kcuzner/led-watch/cad/Custom.fcstd

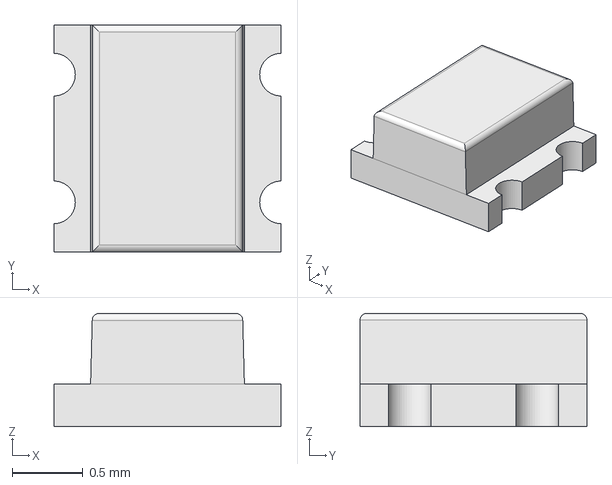
[picture p3: CAD file, 2016-12-05]
cad/Custom.fcstd
1.60 x 1.60 x 0.8 mm
