kcuzner/led-watch/(list of files, cad)

Other CAD files:
cad/stencil.blend
