kcuzner/led-watch/(threads)

Thread 2 (2022-01-03):

I need your help

yap241986, 2022-01-03:
Can you create a boot loader for Debian?
Or how can I?

kcuzner, 2022-01-03:
I'm not sure what you are asking? The project you have commented on is a bare-metal microcontroller-based project and the bootloader here is a structure which facilitates choosing which of two binaries to run. It is not able to, and cannot ever, boot Linux.

Bootloaders for operating systems like Linux are somewhat more complicated, but you can use projects like [Yocto](https://www.yoctoproject.org/) to get started. If you're trying to make a UEFI-compatible bootloader, I would suggest reading the [grub2](https://github.com/rhboot/grub2) source code (or perhaps just using grub directly).

I'm feeling generous, so I'll write you a book as an answer :).

You're going to have to get a lot more specific and do a lot more research, but here are some questions to help you get started:

 - What hardware are you developing for?
   - **Traditional motherboard, using a processor from AMD/Intel/etc**: Check out grub and UEFI, learn how they work. If you're interested in writing a BIOS, most companies hire out a vendor like [Phoenix Technologies](https://www.phoenix.com/) to write their BIOS's. Writing a BIOS is extraordinarily complex and not something you'll be able to do on your own until you learn a lot more, start a company, and sign a few NDAs with AMD and Intel.
   - **A microcontroller, like this project**: A "bootloader" for these systems is a small piece of software that runs before the actual application is run in order to decide which version to run. This is inherently linked to the concept of "firmware update" and providing a "fallback" for the case where a firmware update is interrupted by the power being shut off or a communications error.
     - Most microcontrollers cannot run Linux in the first place. They don't have an MMU or the required protections for an operating system like Linux to run correctly. You need an applications processor, such as an ARM Cortex-R82 or something more advanced. Many vendors, including Microchip Inc, ST, NXP/Freescale, and TI create Linux-capable microprocessors and will provide bootloaders for you.
 - Why do you need to write a bootloader?
   - If you need to write it so you can faciliate firmware update to a single-program microcontroller, than this repo should be able to help you get started.
   - If you don't know why you need a bootloader, then you probably don't need one.
     - Most PCs, including embedded ones like the Raspberry Pi, have a bootloader already built-in for you. Custom bootloaders are a big deal and very complex. One of those things where "if you're asking the question, you don't know what you don't know".
     - Most microprocessors have a bootloader supplied by their vendor, if they even require a bootloader (many of them don't, especially if they've got integrated flash memory). Unless you have a company and are signing NDAs, you cannot write your own bootloader for these and you must use theirs.
     - Most microcontrollers do not require a bootloader to function at all and many applications can get away with not having any sort of bootloader. You'll only need one if you're intending to support in-field firmware updates really.

Closed 2022-01-04.

Thread 4 (2023-07-31):

ARM assembly error in file /common/src/debug.c line 55

Eqqm4n, 2023-07-31:
Hello- been porting this code and compiling under Segger Embedded Studio for ARM 7.12 (I care about the bootloading, not the watch functionality, as a point of reference).  This generates a compile error in debug.c line 55, the line itself is 'movs r1, lr'.  The error given is:

invalid instruction, any one of the following would fix this:
instantiated into assembly here
operand must be an immediate in the range [0,255]
instantiated into assembly here
operand must be a register in range [r0, r7]
instantiated into assembly here

Since I noticed that the original source looked to be compiled as a project for Atollic Studio which is now part of ST's CubeMX IDE, I compiled this under Cube as well and happened to get this same error.  This code is included as part of the replacement Hard Fault handler, so I looked at the default handler provided by Segger and saw it was virtually identical.  So replacing the 'movs' with 'mov' as Segger uses addressed the problem.  Note that this doesn't ensure the code is functionally correct, it just removes a compilation error.  The complete section is as follows:
movs r0, #4
movs r1, lr,
test r0, r1
I believe the 's' suffix tells the ALU status bits to update after the operation.  So if the test command is checking these ALU bits based on the move from the link register, then this will be incorrect, but I don't know how to rewrite this to remove the compilation error and still get the same result of updating the status bits.  It could also be that the test command does not rely on the status bits from the previous two instructions, in which case they can both be replaced with 'mov' (Segger has 'movs' then 'mov') but I haven't done a thorough investigation of what is happening to the processor in this sequence.

kcuzner, 2023-08-06:
I've seen this happen when the wrong core is selected. This specifically was written to compile for the STML052, which I believe is a Cortex-M0+ (and the + is a big deal). The other thing is that this was originally written for GCC, via `arm-none-eabi-gcc`. The original source of cmsis was indeed found in STM32Cube, but the rest of it was written by myself and did not use any IDE (just Makefiles and GCC). That said, looking at debug.c it doesn't fit with my own style and so I wouldn't be surprised if I lifted that from somewhere else. But nonetheless, it was known to compile for GCC.

It's been a long time, but I believe what that code is doing is checking if it should be using the PSP or MSP as the stack pointer and loading whatever is pointed to by stack pointer into the 5th position of the argument array for `HardFault_HandlerC` (`stacked_lr`?). I think when a hard fault happens the `lr` gets updated with a flag saying if the MSP or PSP was in use and so this is decoding that value and allowing the `stacked_lr` value to point to the correct new link register. But I'm guessing. It's been a long time like I said :).

Looking at your code, I don't think there's any reason we need to have `mov` update the status flags. All it's trying to do is `LR & 0x4` and the `tst` operation is setting the flags that the subsequent `beq` uses. So I think that change is safe.

kcuzner, 2023-08-06:
I would suggest if you're hoping to use my bootloader that you consult my https://github.com/kcuzner/midi-fader project for the latest iteration. This one hasn't been tested in a while and I do recall some unreliability issues I had. The midi-fader one is better.

Eqqm4n, 2023-08-08:
Thank you for the response.  All of the STM32L0 line should be Cortex M0+so I wouldn't expect a compilation difference on those lines between the L052 and L062.  The code seems questionable on its face since with two 'movss' commands in a row the flags from the first move are being replaced without even being tested.  I'm sure it probably hasn't been properly reviewed in decades :).

I'll give the midi-fader project a check.  If you actively maintain projects it may be worth it to split bootloading off into its own separate repository.  I only ended up here after finding a reference to your project on an Adafruit blog when looking up STM32 bootloaders on the web.

kcuzner, 2023-10-08:
I'll take that suggestion for having a separate repository for the bootloader, though my personal projects (which all of these are) tend to focus more on learning something new and thus I tend to go with the "copy paste" style of leverage, iterating on the thing after pasting and rarely revisiting or backporting.

Closed 2023-10-08.

Thread 5 (2023-08-06):

Bootloading Python script cannot find attached watch

Eqqm4n, 2023-08-06:
The wristwatch.py script function 'find_device' starting at line 64 cannot connect to an attached watch.  It is looping over all the detected HID devices that match the VID/PID for the watch and then checking for the correct Manufacturer/Product pair.  However, this information is not present in the HID objects being generated by the hid.enumerate() function.  If you print one of these objects you get this ::

{'path': b'3-2:1.0', 'vendor_id': 5824, 'product_id': 1500, 'serial_number': '', 'release_number': 17, 'manufacturer_string': '', 'product_string': '', 'usage_page': 0, 'usage': 0, 'interface_number': 0}

...so you can see that the Manufacturer/Product entries are null values.  This makes sense since the MANUFACTURER='kevincuzner.com', PRODUCT='LED Wristwatch' values that are being searched for don't appear in the STM32 project code.  The USB descriptor defined for the watch in the usb_desc.c file is ::
/**
 * Device descriptor
 */
static const USB_DATA_ALIGN uint8_t dev_descriptor[] = {
    18, //bLength
    1, //bDescriptorType
    0x00, 0x02, //bcdUSB
    0x00, //bDeviceClass (defined by interfaces)
    0x00, //bDeviceSubClass
    0x00, //bDeviceProtocl
    USB_CONTROL_ENDPOINT_SIZE, //bMaxPacketSize0
    0xc0, 0x16, //idVendor
    0xdc, 0x05, //idProduct
    0x11, 0x00, //bcdDevice
    1, //iManufacturer
    2, //iProduct
    0, //iSerialNumber,
    1, //bNumConfigurations
};
...so as can be seen here, iManufacturer and iProduct don't point to a string.  To get around this issue I am simply disabling the checks for Manufacturer/Product and just returning the first object found matching the correct VID/PID which should already be unique enough as it is.  But I'm left curious though as to how this code could have ever worked initially.

kcuzner, 2023-08-06:
This is a permissions issue. You need to see if the handle to the device in `/dev` is readable and writable by your user. If it isn't you'll not be able to actually query the device. Similar behavior can be observed by running `lsusb -v` and then `sudo lsusb -v`. You'll find that the `sudo` version outputs much more information as it opens the device handles and queries for more extensive information.

To remedy this you'll need to either run the python script with `sudo` or add a `udev` rule like this to `/etc/udev/rules.d/`. I typically name mine something like `99-hidraw.rules` or `10-voti.rules`. The number at the beginning is used for sorting to ensure a certain order when processing the rules.

```
# Permissions for libusb raw acccess
SUBSYSTEM=="usb", ATTRS{idVendor}=="16c0", ATTRS{idProduct}=="05dc", MODE="0666"

# Permissions for higher-level hidraw access (this is what Python uses)
KERNEL=="hidraw*", ATTRS{busnum}=="1", ATTRS{idVendor}=="16c0", ATTRS{idProduct}=="05dc", MODE="0666"
```

Eqqm4n, 2023-08-08:
Thank you for the response.  I'm not clear on how this comes down to a permissions issue since as I mentioned the 'kevincuzner.com' and 'LED Wristwatch' strings don't appear anywhere in the C code, so how could they possibly be included in the USB descriptor?

kcuzner, 2023-10-08:
Sorry for the late reply. Please see this file: https://github.com/kcuzner/led-watch/blob/master/firmware/src/usb_desc.c

In my later projects, such as the midi-fader, I used an xml-based `descriptorgen.py` which scans comments for XML and assembles the descriptors from them, including string descriptors like these.

Thread 6 (2023-08-06):

Error attempting to open HID object

Eqqm4n, 2023-08-06:
The hidapi library crashes attempting to open the object returned by the wristwatch.py script's find_device() function ::

Traceback (most recent call last):
  File "/home/perfecta/Downloads/led-watch-master/host/bootloader", line 68, in <module>
    main()
  File "/home/perfecta/Downloads/led-watch-master/host/bootloader", line 54, in main
    with open_bootloader(args.timeout) as dev:
  File "/home/perfecta/Downloads/led-watch-master/host/device/wristwatch.py", line 40, in __enter__
    self.open_path(self.path)
  File "hid.pyx", line 157, in hid.device.open_path
OSError: open failed

If you check the file name and line number reported for hid.pyx you'll see this function ::

    def open_path(self, bytes path):
        """Open connection by path.

        :param path: Path to device
        :type path: bytes
        :raises IOError:
        """
        cdef char* cbuff = path
        if self._c_hid != NULL:
            raise RuntimeError('already open')
        self._c_hid = hid_open_path(cbuff)
        if self._c_hid == NULL:
            raise IOError('open failed')
        self._close = weakref.finalize(self, _closer.wrap(self._c_hid).close)
...and I verified that the 'path' parameter is this object :: {'path': b'3-2:1.0'}.  In order to raise the IOError then there must have been a failure of the hid_open_path() function call, but how to troubleshoot this further is unclear as I don't know how to reconstruct the 'cdef char* cbuff = path' line when trying to do these things step by step via running the Python interpreter directly.

kcuzner, 2023-08-06:
Please check that your user is able to access the hidraw handle and/or USB handle in `dev` and if it doesn't have write permissions, add a `udev` rule or use `sudo` to run the script as noted in #5

Eqqm4n, 2023-08-08:
Thank you for the response.  Running the script with sudo cleared that up.

Closed 2023-10-08.
