kcuzner/led-watch/kicad/simple-led-watch.kicad_pcb

## KiCad design kicad/simple-led-watch.kicad_pcb (2017-01-29)

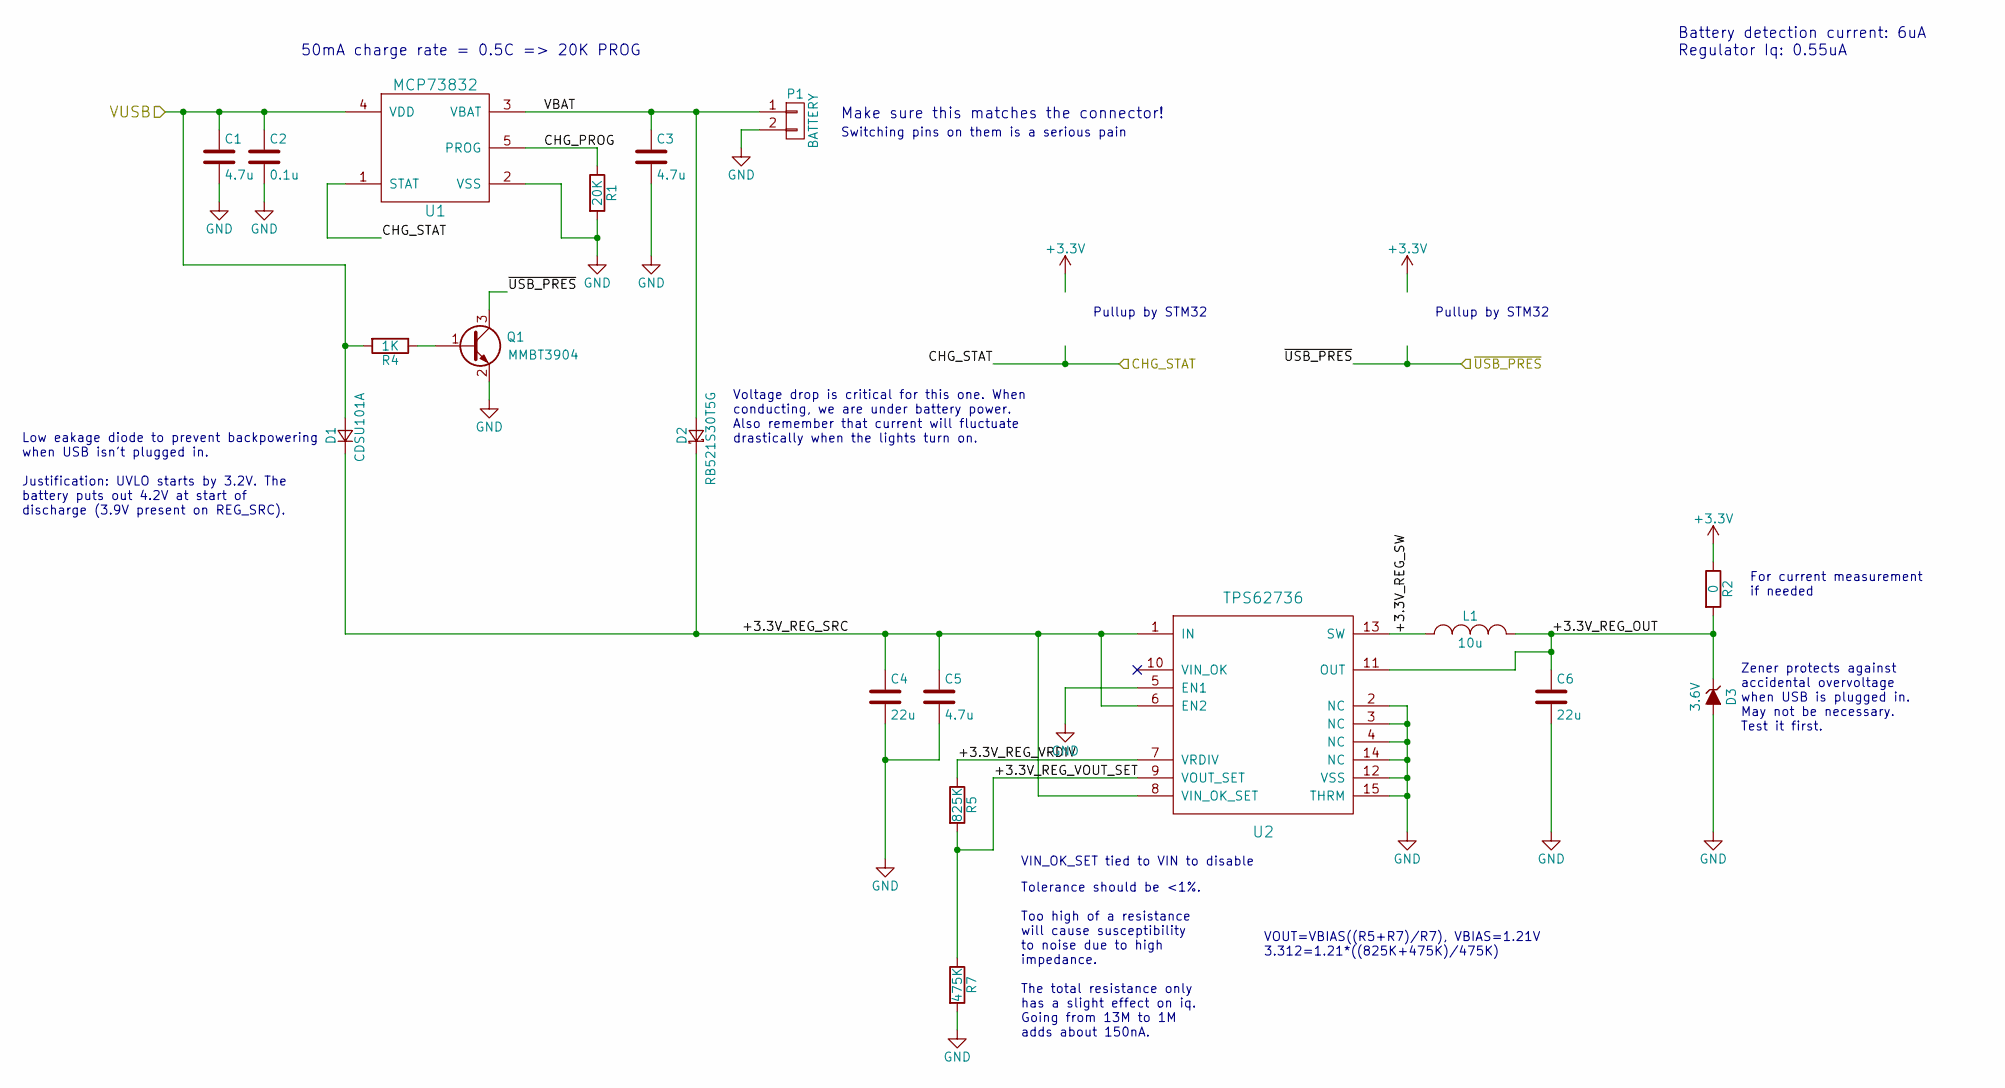
[picture p4: schematic power-supply.sch, LED Watch, STM32L0]

Parts:
C1, C3, C5: 4.7u; C_0402; Part No. 1276-6819-1-ND
C2: 0.1u; C_0402; Part No. 1276-1022-1-ND
C4, C6: 22u; C_0603; Part No. 1276-6504-1-ND
D1: CDSU101A; SOD-523; Part No. 641-1002-1-ND
D2: RB521S30T5G; SOD-523; Part No. RB521S30T5GOSCT-ND
D3: 3.6V; SOD-523; Part No. DZ2S036M0LCT-ND
L1: 10u; SMD_1008; Part No. 490-10563-1-ND
P1: BATTERY; JST-ACH-2PIN; Part No. 455-2202-1-ND
Q1: MMBT3904; SOT-23; Part No. MMBT3904FSCT-ND
R1: 20K; R_0402; Part No. 311-20.0KLRCT-ND
R2: 0; R_0402; Part No. 311-0.0JRCT-ND
R4: 1K; R_0402; Part No. 311-1.00KLRCT-ND
R5: 825K; R_0402; Part No. YAG3241CT-ND
R7: 475K; R_0402; Part No. 311-475KLRCT-ND
U1: MCP73832; SOT-23-5; Part No. MCP73832T-2DCI/OTCT-ND
U2: TPS62736; 14-VQFN; Part No. 296-43622-1-ND

Connections:
+3V3: R2.1; also elsewhere on the board
/Control/CHG_STAT: U1.1 (STAT); also elsewhere on the board
/Control/~USB_PRES: Q1.3 (C); also elsewhere on the board
/Power Supply/+3.3V_REG_OUT: C6.1, D3.1 (K), L1.2, R2.2, U2.11 (OUT)
/Power Supply/+3.3V_REG_SRC: C4.1, C5.1, D1.1 (K), D2.1 (K), U2.1 (IN), U2.6 (EN2), U2.8 (VIN_OK_SET)
/Power Supply/+3.3V_REG_SW: L1.1, U2.13 (SW)
/Power Supply/+3.3V_REG_VOUT_SET: R5.2, R7.1, U2.9 (VOUT_SET)
/Power Supply/+3.3V_REG_VRDIV: R5.1, U2.7 (VRDIV)
/Power Supply/CHG_PROG: R1.1, U1.5 (PROG)
/Power Supply/VBAT: C3.1, D2.2 (A), P1.1, U1.3 (VBAT)
/Power Supply/VUSB: C1.1, C2.1, D1.2 (A), R4.2, U1.4 (VDD); also elsewhere on the board
GND: C1.2, C2.2, C3.2, C4.2, C5.2, C6.2, D3.2 (A), P1.2, Q1.2 (E), R1.2, R7.2, U1.2 (VSS), U2.2 (NC), U2.3 (NC), U2.4 (NC), U2.5 (EN1), U2.12 (VSS), U2.14 (NC), U2.15 (THRM); also elsewhere on the board
unnamed: Q1.1 (B), R4.1

Notes on the sheet:
50mA charge rate = 0.5C => 20K PROG
Make sure this matches the connector!
Switching pins on them is a serious pain
Battery detection current: 6uA Regulator Iq: 0.55uA
Low eakage diode to prevent backpowering when USB isn't plugged in. Justification: UVLO starts by 3.2V. The battery puts out 4.2V at start of discharge (3.9V present on REG_SRC).
Voltage drop is critical for this one. When conducting, we are under battery power. Also remember that current will fluctuate drastically when the lights turn on.
Pullup by STM32
For current measurement if needed
Zener protects against accidental overvoltage when USB is plugged in. May not be necessary. Test it first.
VIN_OK_SET tied to VIN to disable
Tolerance should be <1%. Too high of a resistance will cause susceptibility to noise due to high impedance. The total resistance only has a slight effect on iq. Going from 13M to 1M adds about 150nA.
VOUT=VBIAS((R5+R7)/R7), VBIAS=1.21V 3.312=1.21*((825K+475K)/475K)

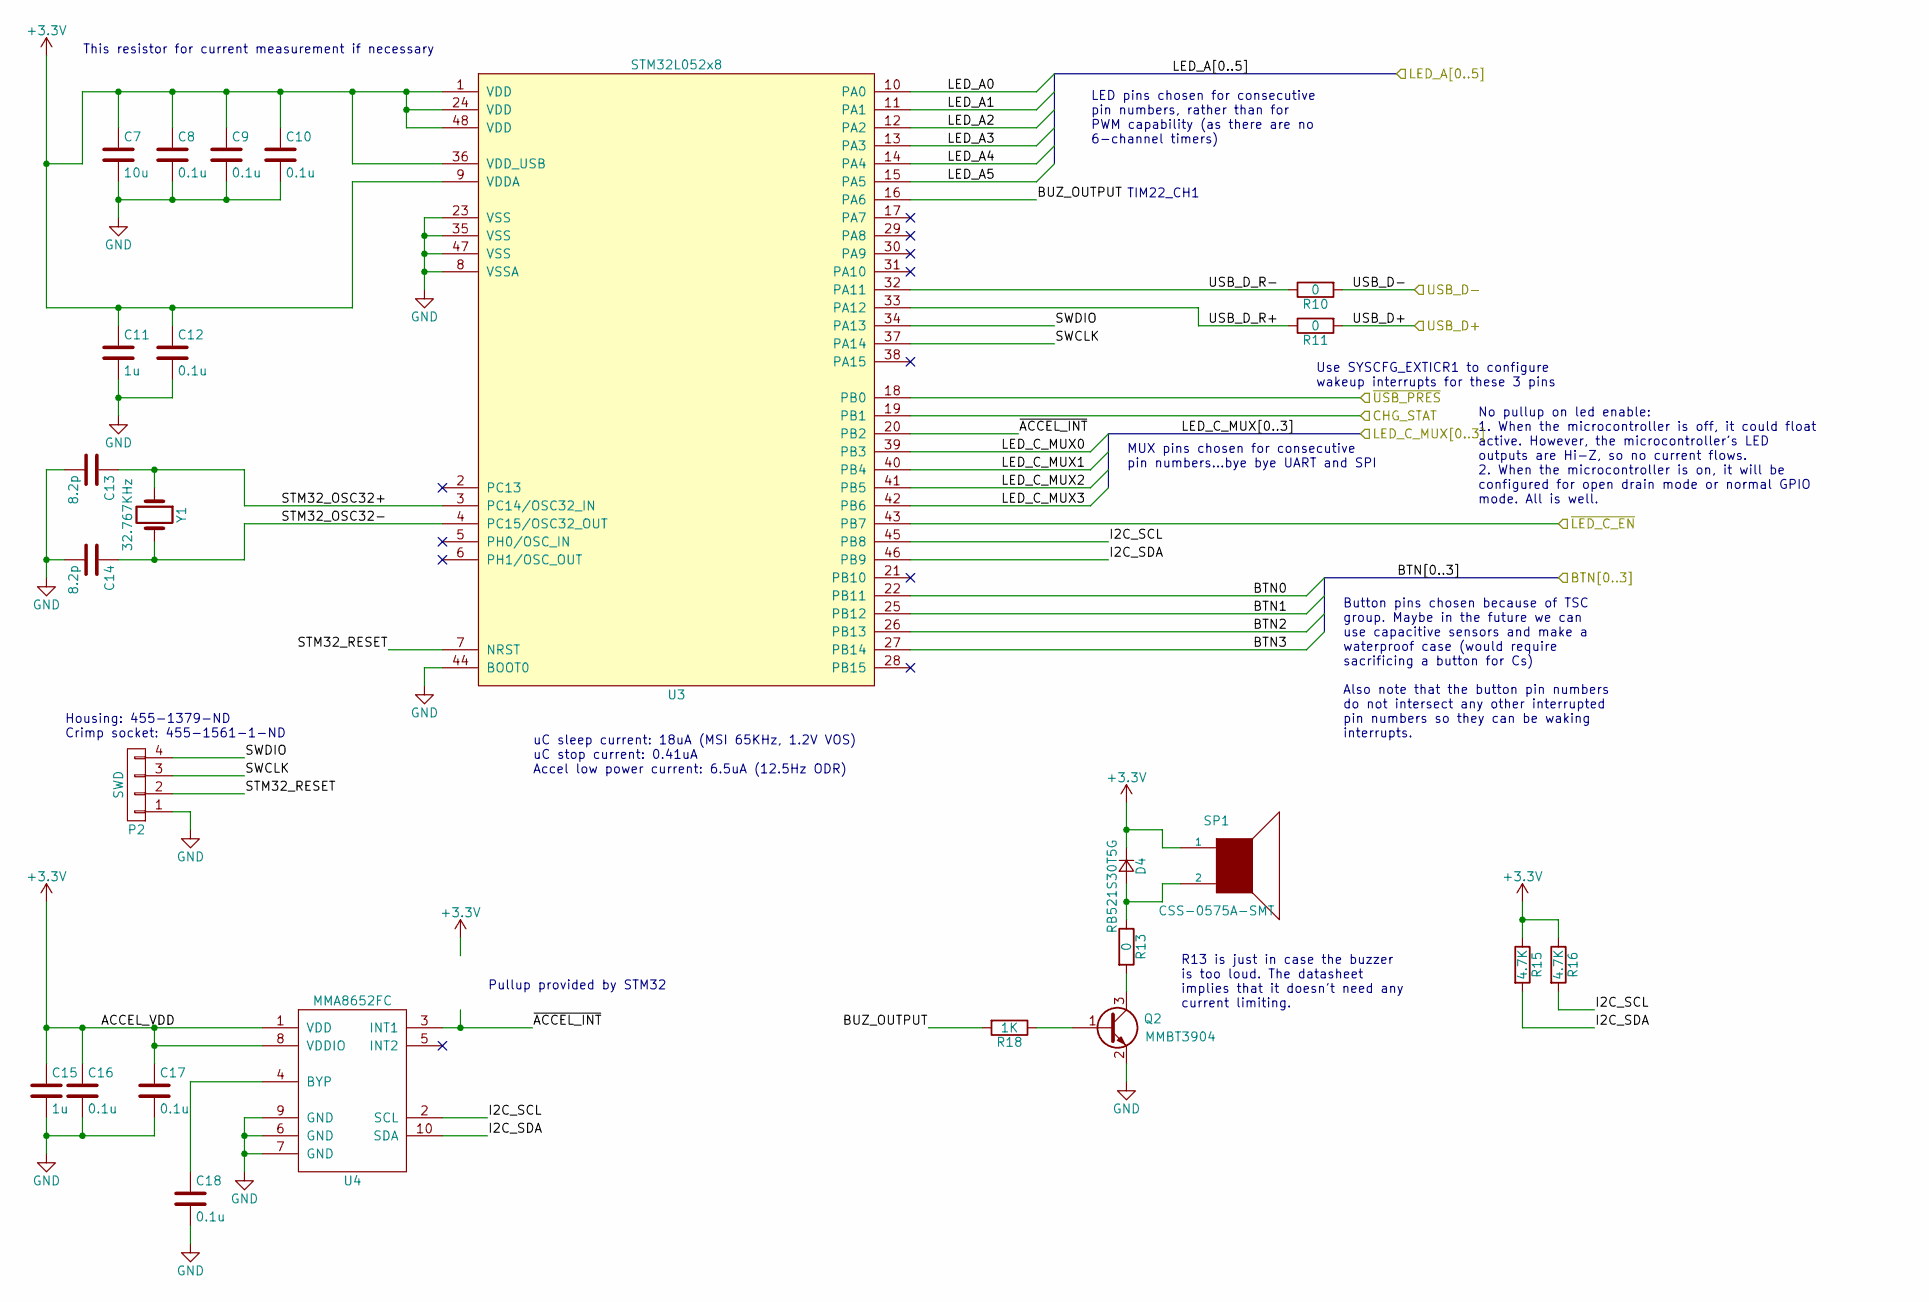
[picture p5: schematic control.sch, LED Watch, STM32L0]

Parts:
C7: 10u; C_0402; Part No. 1276-6830-1-ND
C8, C9, C10, C12, C16, C17, C18: 0.1u; C_0402; Part No. 1276-1022-1-ND
C11, C15: 1u; C_0402; Part No. 1276-1448-1-ND
C13, C14: 8.2p; C_0402; Part No. 490-6256-1-ND
D4: RB521S30T5G; SOD-523; Part No. RB521S30T5GOSCT-ND
P2: SWD; JST-SH-4; Part No. 455-1790-1-ND
Q2: MMBT3904; SOT-23; Part No. MMBT3904FSCT-ND
R10, R11, R13: 0; R_0402; Part No. 311-0.0JRCT-ND
R15, R16: 4.7K; R_0402; Part No. 311-4.7KLRCT-ND
R18: 1K; R_0402; Part No. 311-10.0KLRCT-ND
SP1: CSS-0575A-SMT; Part No. 102-2201-1-ND
U3: STM32L052x8; LQFP-48_7x7mm_Pitch0.5mm; Part No. 497-14903-ND
U4: MMA8652FC; 10-DFN; Part No. MMA8652FCR1CT-ND
Y1: 32.767KHz; Crystal-Abracon-ABS07; Part No. 535-11937-1-ND

Connections:
+3V3: C7.1, C8.1, C9.1, C10.1, C11.1, C12.1, C15.1, C16.1, C17.1, D4.1 (K), R15.1, R16.1, SP1.1, U3.1 (VDD), U3.9 (VDDA), U3.24 (VDD), U3.36 (VDD_USB), U3.48 (VDD), U4.1 (VDD), U4.8 (VDDIO); also elsewhere on the board
/Control/BTN0: U3.22 (PB11); also elsewhere on the board
/Control/BTN1: U3.25 (PB12); also elsewhere on the board
/Control/BTN2: U3.26 (PB13); also elsewhere on the board
/Control/BTN3: U3.27 (PB14); also elsewhere on the board
/Control/BUZ_OUTPUT: R18.2, U3.16 (PA6)
/Control/CHG_STAT: U3.19 (PB1); also elsewhere on the board
/Control/I2C_SCL: R16.2, U3.45 (PB8), U4.2 (SCL)
/Control/I2C_SDA: R15.2, U3.46 (PB9), U4.10 (SDA)
/Control/LED_A0: U3.10 (PA0); also elsewhere on the board
/Control/LED_A1: U3.11 (PA1); also elsewhere on the board
/Control/LED_A2: U3.12 (PA2); also elsewhere on the board
/Control/LED_A3: U3.13 (PA3); also elsewhere on the board
/Control/LED_A4: U3.14 (PA4); also elsewhere on the board
/Control/LED_A5: U3.15 (PA5); also elsewhere on the board
/Control/LED_C_MUX0: U3.39 (PB3); also elsewhere on the board
/Control/LED_C_MUX1: U3.40 (PB4); also elsewhere on the board
/Control/LED_C_MUX2: U3.41 (PB5); also elsewhere on the board
/Control/LED_C_MUX3: U3.42 (PB6); also elsewhere on the board
/Control/STM32_OSC32+: C13.1, U3.3 (PC14/OSC32_IN), Y1.1
/Control/STM32_OSC32-: C14.1, U3.4 (PC15/OSC32_OUT), Y1.2
/Control/STM32_RESET: P2.2, U3.7 (NRST)
/Control/SWCLK: P2.3, U3.37 (PA14)
/Control/SWDIO: P2.4, U3.34 (PA13)
/Control/USB_D+: R11.2; also elsewhere on the board
/Control/USB_D-: R10.2; also elsewhere on the board
/Control/USB_D_R+: R11.1, U3.33 (PA12)
/Control/USB_D_R-: R10.1, U3.32 (PA11)
/Control/~ACCEL_INT: U3.20 (PB2), U4.3 (INT1)
/Control/~LED_C_EN: U3.43 (PB7); also elsewhere on the board
/Control/~USB_PRES: U3.18 (PB0); also elsewhere on the board
GND: C7.2, C8.2, C9.2, C10.2, C11.2, C12.2, C13.2, C14.2, C15.2, C16.2, C17.2, C18.2, P2.1, Q2.2 (E), U3.8 (VSSA), U3.23 (VSS), U3.35 (VSS), U3.44 (BOOT0), U3.47 (VSS), U4.6 (GND), U4.7 (GND), U4.9 (GND); also elsewhere on the board
unnamed: C18.1, U4.4 (BYP)
unnamed: D4.2 (A), R13.1, SP1.2
unnamed: Q2.1 (B), R18.1
unnamed: Q2.3 (C), R13.2

Notes on the sheet:
This resistor for current measurement if necessary
LED pins chosen for consecutive pin numbers, rather than for PWM capability (as there are no 6-channel timers)
uC sleep current: 18uA (MSI 65KHz, 1.2V VOS) uC stop current: 0.41uA Accel low power current: 6.5uA (12.5Hz ODR)
MUX pins chosen for consecutive pin numbers...bye bye UART and SPI
Button pins chosen because of TSC group. Maybe in the future we can use capacitive sensors and make a waterproof case (would require sacrificing a button for Cs)
Use SYSCFG_EXTICR1 to configure wakeup interrupts for these 3 pins
TIM22_CH1
Also note that the button pin numbers do not intersect any other interrupted pin numbers so they can be waking interrupts.
No pullup on led enable: 1. When the microcontroller is off, it could float active. However, the microcontroller's LED outputs are Hi-Z, so no current flows. 2. When the microcontroller is on, it will be configured for open drain mode or normal GPIO mode. All is well.
Pullup provided by STM32
Housing: 455-1379-ND Crimp socket: 455-1561-1-ND
R13 is just in case the buzzer is too loud. The datasheet implies that it doesn't need any current limiting.

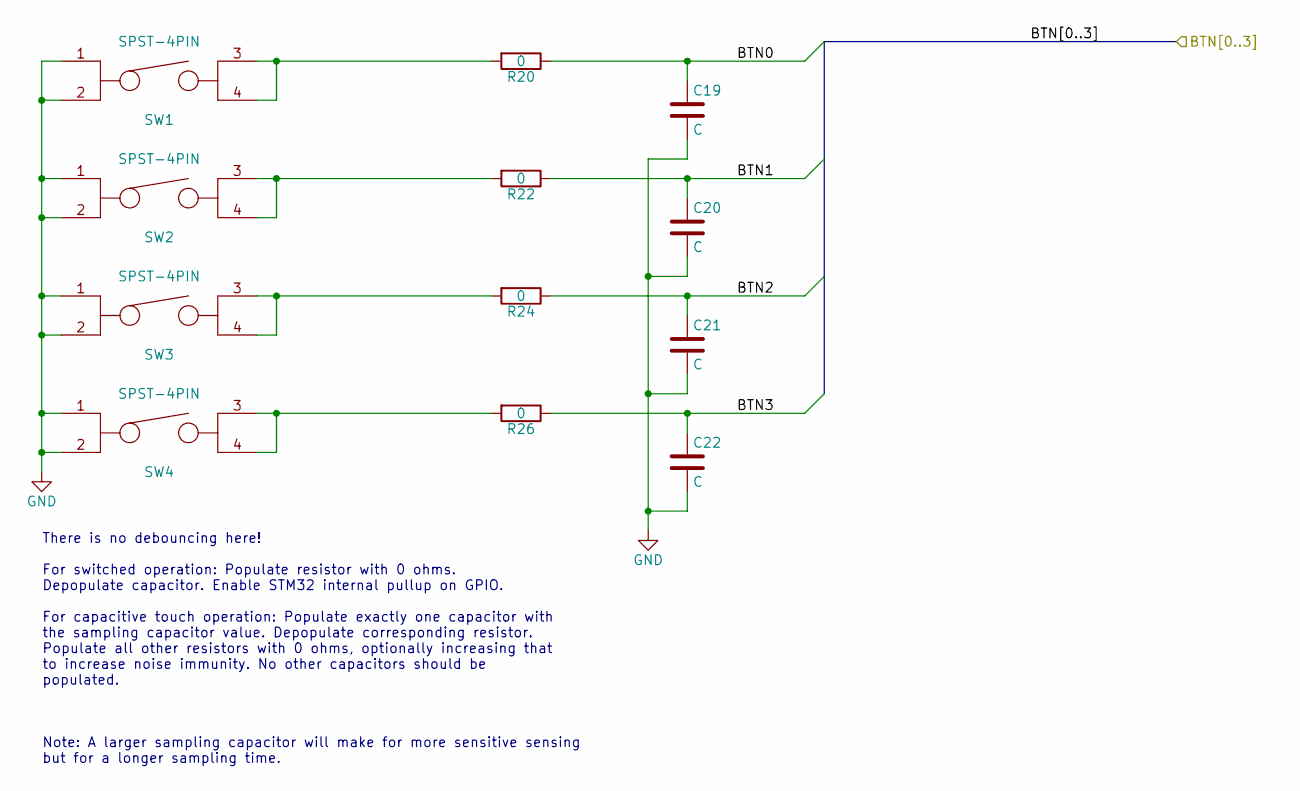
[picture p6: schematic input.sch, LED Watch, STM32L0]

Parts:
C19, C20, C21, C22: C; C_0402
R20, R22, R24, R26: 0; R_0402; Part No. 311-0.0JRCT-ND
SW1, SW2, SW3, SW4: SPST-4PIN; PAN-EVPAV; Part No. P16849CT-ND

Connections:
/Control/BTN0: C19.1, R20.1; also elsewhere on the board
/Control/BTN1: C20.1, R22.1; also elsewhere on the board
/Control/BTN2: C21.1, R24.1; also elsewhere on the board
/Control/BTN3: C22.1, R26.1; also elsewhere on the board
GND: C19.2, C20.2, C21.2, C22.2, SW1.1, SW1.2, SW2.1, SW2.2, SW3.1, SW3.2, SW4.1, SW4.2; also elsewhere on the board
unnamed: R20.2, SW1.3, SW1.4
unnamed: R22.2, SW2.3, SW2.4
unnamed: R24.2, SW3.3, SW3.4
unnamed: R26.2, SW4.3, SW4.4

Notes on the sheet:
Note: A larger sampling capacitor will make for more sensitive sensing but for a longer sampling time.
There is no debouncing here! For switched operation: Populate resistor with 0 ohms. Depopulate capacitor. Enable STM32 internal pullup on GPIO. For capacitive touch operation: Populate exactly one capacitor with the sampling capacitor value. Depopulate corresponding resistor. Populate all other res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

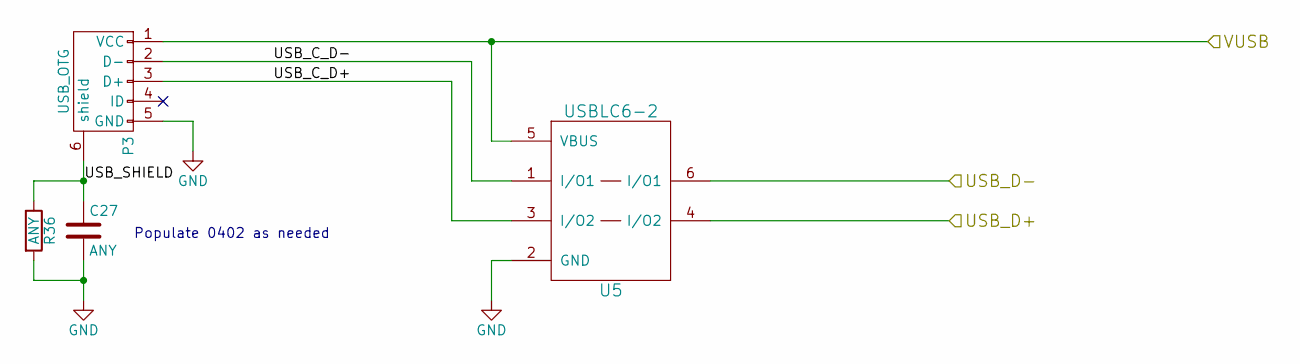
[picture p7: schematic usb.sch, LED Watch, STM32L0]

Parts:
C27: ANY; C_0402
P3: USB_OTG; AMP-10104110-USB; Part No. 609-4052-1-ND
R36: ANY; R_0402
U5: USBLC6-2; SOT-666; Part No. 497-5026-1-ND

Connections:
/Control/USB_D+: U5.4 (I/O2); also elsewhere on the board
/Control/USB_D-: U5.6 (I/O1); also elsewhere on the board
/Power Supply/VUSB: P3.1 (VCC), U5.5 (VBUS); also elsewhere on the board
/USB/USB_C_D+: P3.3 (D+), U5.3 (I/O2)
/USB/USB_C_D-: P3.2 (D-), U5.1 (I/O1)
/USB/USB_SHIELD: C27.1, P3.6 (shield), R36.1
GND: C27.2, P3.5 (GND), R36.2, U5.2 (GND); also elsewhere on the board

Notes on the sheet:
Populate 0402 as needed

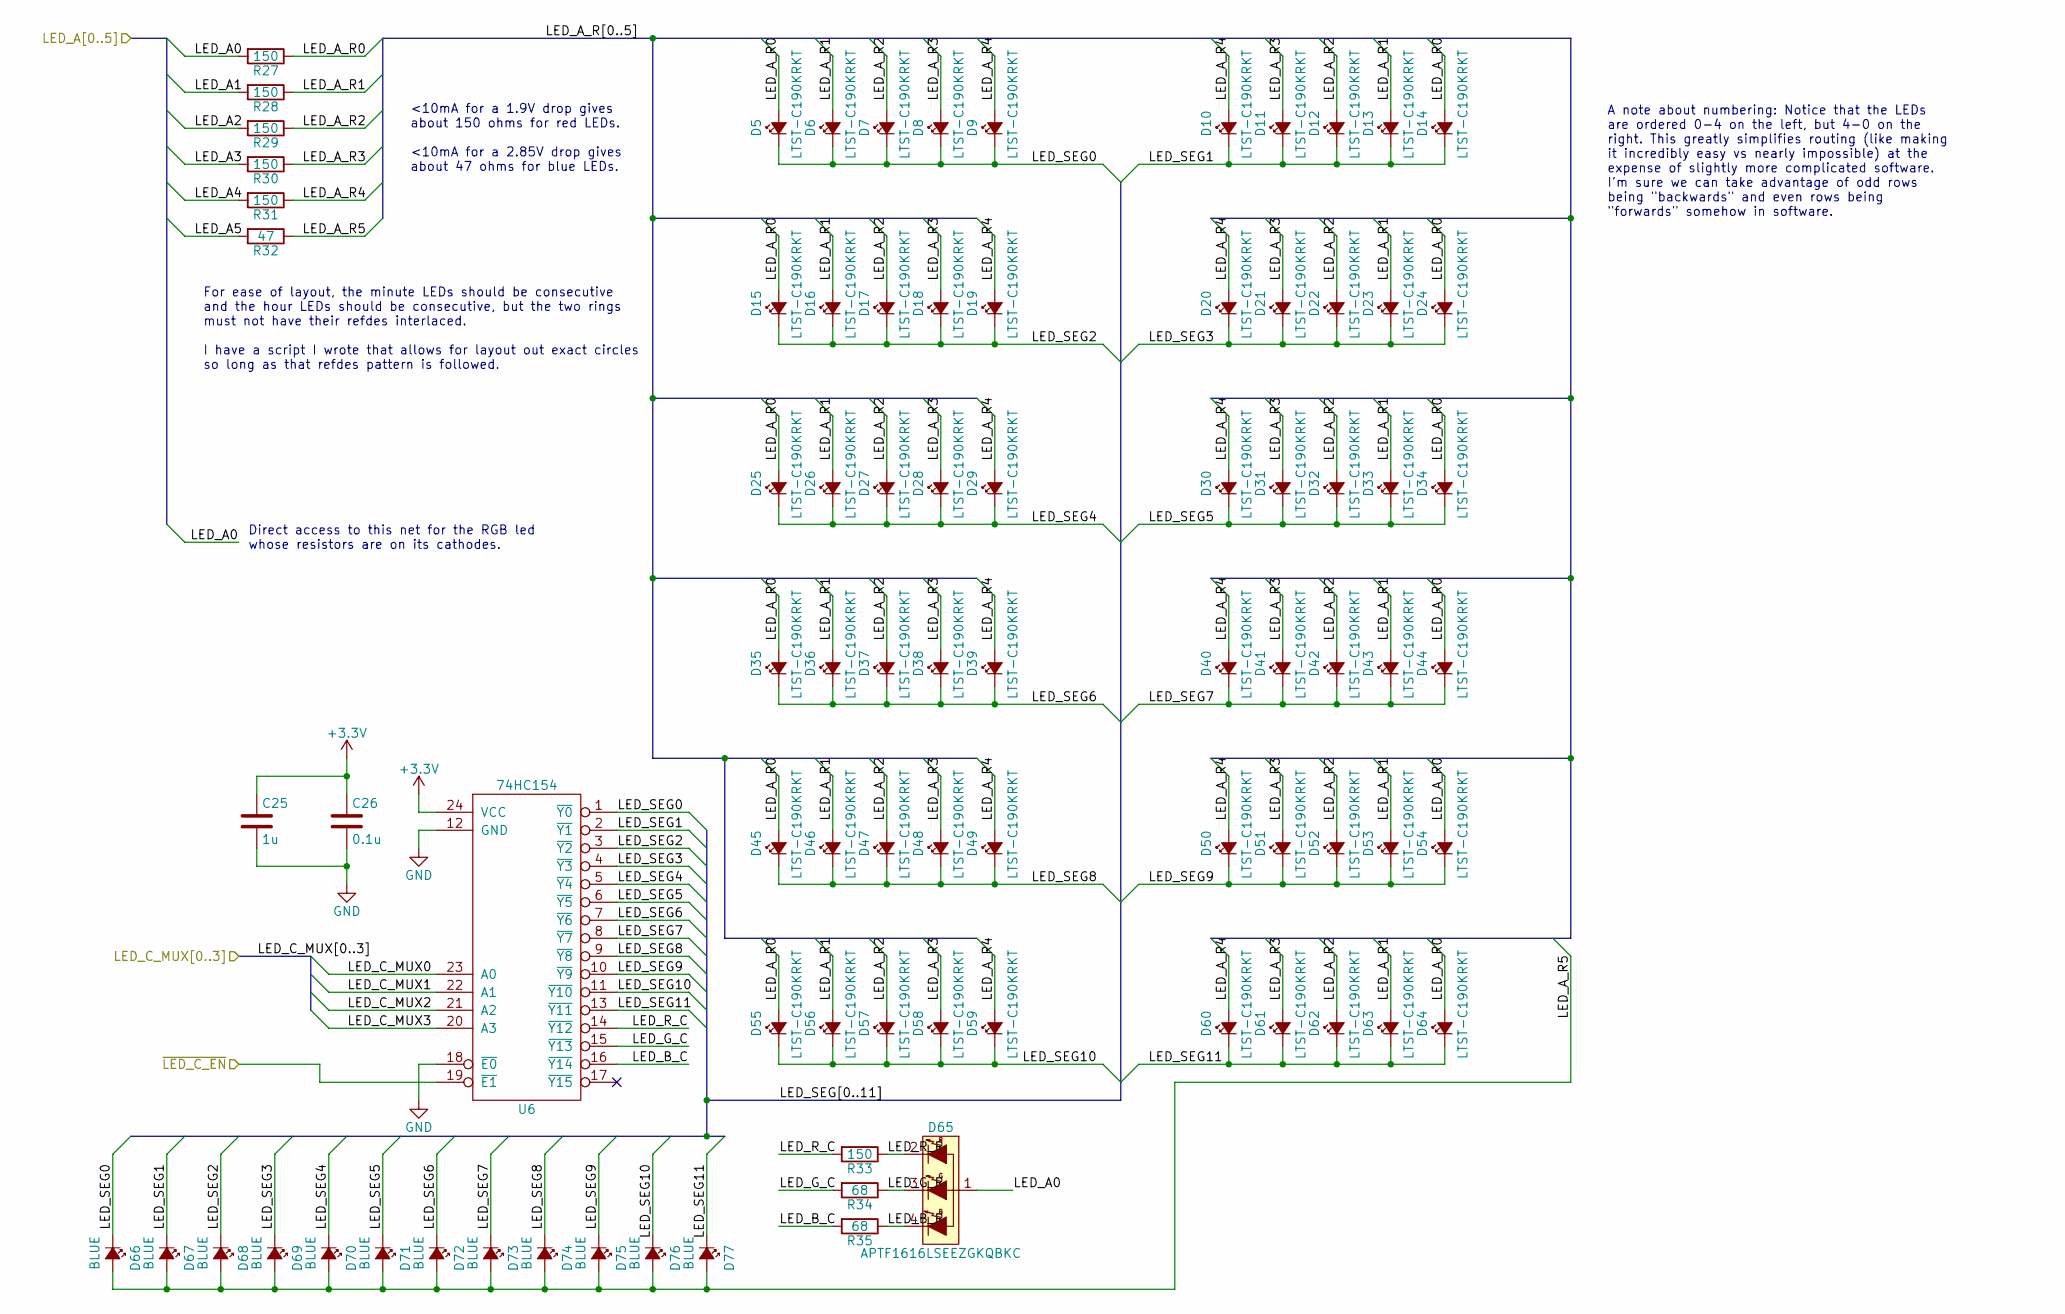
[picture p8: schematic leds.sch, LED Watch, STM32L0]

Parts:
C25: 1u; C_0402; Part No. 1276-1448-1-ND
C26: 0.1u; C_0402; Part No. 1276-1022-1-ND
D5, D6, D7, D8, D9, D10, D11, D12, D13, D14, D15, D16, D17, D18, D19, D20, D21, D22, D23, D24, D25, D26, D27, D28, D29, D30, D31, D32, D33, D34, D35, D36, D37, D38, D39, D40, D41, D42, D43, D44, D45, D46, D47, D48, D49, D50, D51, D52, D53, D54, D55, D56, D57, D58, D59, D60, D61, D62, D63, D64: LTST-C190KRKT; LED_0603; Part No. 160-1436-1-ND
D65: APTF1616LSEEZGKQBKC; LED-0606; Part No. 754-1972-1-ND
D66, D67, D68, D69, D70, D71, D72, D73, D74, D75, D76, D77: BLUE; LED_0603; Part No. 475-2815-1-ND
R27, R28, R29, R30, R31, R33: 150; R_0402; Part No. 311-150LRCT-ND
R32: 47; R_0402; Part No. 311-47.0LRCT-ND
R34, R35: 68; R_0402; Part No. 311-68.0LRCT-ND
U6: 74HC154; DHVQFN24; Part No. 568-8858-1-ND

Connections:
+3V3: C25.1, C26.1, U6.24 (VCC); also elsewhere on the board
/Control/LED_A0: D65.1, R27.2; also elsewhere on the board
/Control/LED_A1: R28.2; also elsewhere on the board
/Control/LED_A2: R29.2; also elsewhere on the board
/Control/LED_A3: R30.2; also elsewhere on the board
/Control/LED_A4: R31.2; also elsewhere on the board
/Control/LED_A5: R32.2; also elsewhere on the board
/Control/LED_C_MUX0: U6.23 (A0); also elsewhere on the board
/Control/LED_C_MUX1: U6.22 (A1); also elsewhere on the board
/Control/LED_C_MUX2: U6.21 (A2); also elsewhere on the board
/Control/LED_C_MUX3: U6.20 (A3); also elsewhere on the board
/Control/~LED_C_EN: U6.19 (~E1); also elsewhere on the board
/LEDs/LED_A_R0: D5.2 (A), D14.2 (A), D15.2 (A), D24.2 (A), D25.2 (A), D34.2 (A), D35.2 (A), D44.2 (A), D45.2 (A), D54.2 (A), D55.2 (A), D64.2 (A), R27.1
/LEDs/LED_A_R1: D6.2 (A), D13.2 (A), D16.2 (A), D23.2 (A), D26.2 (A), D33.2 (A), D36.2 (A), D43.2 (A), D46.2 (A), D53.2 (A), D56.2 (A), D63.2 (A), R28.1
/LEDs/LED_A_R2: D7.2 (A), D12.2 (A), D17.2 (A), D22.2 (A), D27.2 (A), D32.2 (A), D37.2 (A), D42.2 (A), D47.2 (A), D52.2 (A), D57.2 (A), D62.2 (A), R29.1
/LEDs/LED_A_R3: D8.2 (A), D11.2 (A), D18.2 (A), D21.2 (A), D28.2 (A), D31.2 (A), D38.2 (A), D41.2 (A), D48.2 (A), D51.2 (A), D58.2 (A), D61.2 (A), R30.1
/LEDs/LED_A_R4: D9.2 (A), D10.2 (A), D19.2 (A), D20.2 (A), D29.2 (A), D30.2 (A), D39.2 (A), D40.2 (A), D49.2 (A), D50.2 (A), D59.2 (A), D60.2 (A), R31.1
/LEDs/LED_A_R5: D66.2 (A), D67.2 (A), D68.2 (A), D69.2 (A), D70.2 (A), D71.2 (A), D72.2 (A), D73.2 (A), D74.2 (A), D75.2 (A), D76.2 (A), D77.2 (A), R32.1
/LEDs/LED_B_C: R35.2, U6.16 (~Y14)
/LEDs/LED_B_R: D65.4 (B), R35.1
/LEDs/LED_G_C: R34.2, U6.15 (~Y13)
/LEDs/LED_G_R: D65.3 (G), R34.1
/LEDs/LED_R_C: R33.2, U6.14 (~Y12)
/LEDs/LED_R_R: D65.2 (R), R33.1
/LEDs/LED_SEG0: D5.1 (K), D6.1 (K), D7.1 (K), D8.1 (K), D9.1 (K), D66.1 (K), U6.1 (~Y0)
/LEDs/LED_SEG1: D10.1 (K), D11.1 (K), D12.1 (K), D13.1 (K), D14.1 (K), D67.1 (K), U6.2 (~Y1)
/LEDs/LED_SEG2: D15.1 (K), D16.1 (K), D17.1 (K), D18.1 (K), D19.1 (K), D68.1 (K), U6.3 (~Y2)
/LEDs/LED_SEG3: D20.1 (K), D21.1 (K), D22.1 (K), D23.1 (K), D24.1 (K), D69.1 (K), U6.4 (~Y3)
/LEDs/LED_SEG4: D25.1 (K), D26.1 (K), D27.1 (K), D28.1 (K), D29.1 (K), D70.1 (K), U6.5 (~Y4)
/LEDs/LED_SEG5: D30.1 (K), D31.1 (K), D32.1 (K), D33.1 (K), D34.1 (K), D71.1 (K), U6.6 (~Y5)
/LEDs/LED_SEG6: D35.1 (K), D36.1 (K), D37.1 (K), D38.1 (K), D39.1 (K), D72.1 (K), U6.7 (~Y6)
/LEDs/LED_SEG7: D40.1 (K), D41.1 (K), D42.1 (K), D43.1 (K), D44.1 (K), D73.1 (K), U6.8 (~Y7)
/LEDs/LED_SEG8: D45.1 (K), D46.1 (K), D47.1 (K), D48.1 (K), D49.1 (K), D74.1 (K), U6.9 (~Y8)
/LEDs/LED_SEG9: D50.1 (K), D51.1 (K), D52.1 (K), D53.1 (K), D54.1 (K), D75.1 (K), U6.10 (~Y9)
/LEDs/LED_SEG10: D55.1 (K), D56.1 (K), D57.1 (K), D58.1 (K), D59.1 (K), D76.1 (K), U6.11 (~Y10)
/LEDs/LED_SEG11: D60.1 (K), D61.1 (K), D62.1 (K), D63.1 (K), D64.1 (K), D77.1 (K), U6.13 (~Y11)
GND: C25.2, C26.2, U6.12 (GND), U6.18 (~E0); also elsewhere on the board

Notes on the sheet:
For ease of layout, the minute LEDs should be consecutive and the hour LEDs should be consecutive, but the two rings must not have their refdes interlaced. I have a script I wrote that allows for layout out exact circles so long as that refdes pattern is followed.
A note about numbering: Notice that the LEDs are ordered 0-4 on the left, but 4-0 on the right. This greatly simplifies routing (like making it incredibly easy vs nearly impossible) at the expense of slightly more complicated software. I'm sure we can take advantage of odd rows being "backwards" an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
Direct access to this net for the RGB led whose resistors are on its cathodes.
<10mA for a 1.9V drop gives about 150 ohms for red LEDs. <10mA for a 2.85V drop gives about 47 ohms for blue LEDs.

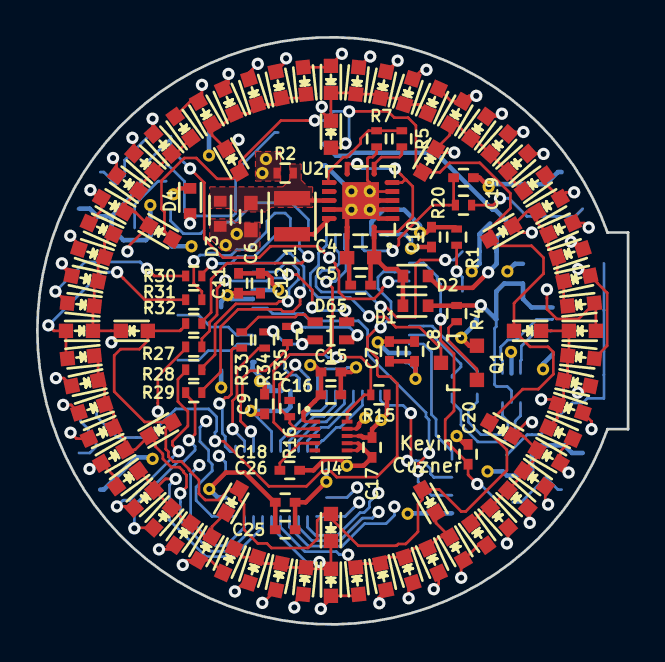
[picture p9: board simple-led-watch.kicad_pcb from above]

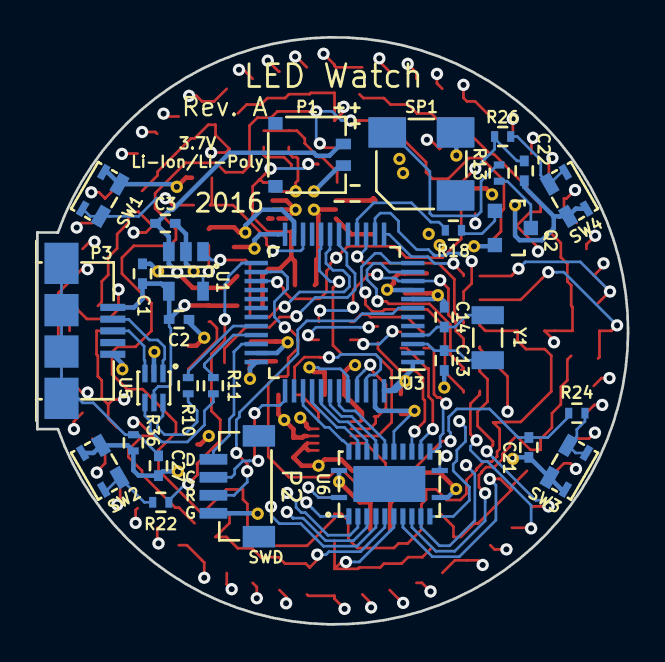
[picture p10: board simple-led-watch.kicad_pcb from below]

Board: 4 copper layers, 32.8 x 32.6 mm, 145 parts (30 on the bottom side), 76 nets.
