kcuzner/led-watch/firmware/src/i2c.c

/**
 * LED Wristwatch
 *
 * Kevin Cuzner
 */

#include "i2c.h"

#include "stm32l0xx.h"
#include "system_stm32l0xx.h"
#include "osc.h"

static void i2c_set_timing(void)
{
    uint32_t prescaler = SystemCoreClock / 2000000;
    if (prescaler > 15)
        prescaler = 15;
    //Set up for master mode, 100KHz, assuming a 2.1MHz clock
    I2C1->TIMINGR = ((prescaler & 0xF) << I2C_TIMINGR_PRESC_Pos) |
        ((5 & 0xF) << I2C_TIMINGR_SCLDEL_Pos) |
        ((5 & 0xF) << I2C_TIMINGR_SDADEL_Pos) |
        ((5 & 0xFF) << I2C_TIMINGR_SCLH_Pos) |
        ((5 & 0xFF) << I2C_TIMINGR_SCLL_Pos);
}

void i2c_init(void)
{
    //Enable clocks
    RCC->APB1ENR |= RCC_APB1ENR_I2C1EN;
    RCC->IOPENR |= RCC_IOPENR_IOPBEN;

    //Set PB8 and PB9 to Alternate Function, AF4
    GPIOB->AFR[1] &= 0xFFFFFF00;
    GPIOB->AFR[1] |= 0x00000044;
    GPIOB->MODER &= ~(GPIO_MODER_MODE8 | GPIO_MODER_MODE9);
    GPIOB->MODER |= GPIO_MODER_MODE8_1 | GPIO_MODER_MODE9_1;
    GPIOB->OTYPER |= GPIO_OTYPER_OT_8 | GPIO_OTYPER_OT_9;

    //Set up timing and add a callback to oscillator changes
    i2c_set_timing();
    osc_add_callback(&i2c_set_timing);
}

/**
 * Waits for the I2C1 peripheral to reach a passed state
 *
 * mask: Mask to match and return true
 *
 * Returns true if any bit in the passed mask is matched or false if any error bit or nack bit is set
 */
static bool i2c_wait_ready(uint16_t mask)
{
    while (true)
    {
        if ((I2C1->ISR & I2C_ISR_ARLO) | (I2C1->ISR & I2C_ISR_BERR) | (I2C1->ISR & I2C_ISR_NACKF))
        {
            return false;
        }
        if (I2C1->ISR & mask)
        {
            return true;
        }
    }
}

bool i2c_write(uint8_t address, uint8_t reg, uint8_t *buffer, uint8_t len)
{
    I2C1->CR1 = I2C_CR1_PE; //enable peripheral

    //send address, register byte, and buffer data
    I2C1->CR2 = I2C_CR2_AUTOEND | ((len + 1) << I2C_CR2_NBYTES_Pos) |
        I2C_CR2_START | (address << I2C_CR2_SADD_Pos);

    I2C1->ISR |= I2C_ISR_TXE;
    I2C1->TXDR = reg;

    uint8_t i = 0;
    do
    {
        if (!i2c_wait_ready(I2C_ISR_STOPF | I2C_ISR_TXIS))
            return false;

        if (I2C1->ISR & I2C_ISR_TXIS)
            I2C1->TXDR = buffer[i++];
    }
    while (!(I2C1->ISR & I2C_ISR_STOPF));

    I2C1->CR1 = 0;

    return true;
}

bool i2c_read(uint8_t address, uint8_t reg, uint8_t *buffer, uint8_t len)
{
    I2C1->CR1 = I2C_CR1_PE; //enable peripheral

    //send address + register byte
    I2C1->CR2 = (1 << I2C_CR2_NBYTES_Pos) |
        I2C_CR2_START | (address << I2C_CR2_SADD_Pos);

    I2C1->ISR |= I2C_ISR_TXE;
    I2C1->TXDR = reg;

    if (!i2c_wait_ready(I2C_ISR_TC))
        return false;

    //restart, send address, read bytes
    I2C1->CR2 = I2C_CR2_AUTOEND | (len << I2C_CR2_NBYTES_Pos) |
        I2C_CR2_START | I2C_CR2_RD_WRN | (address << I2C_CR2_SADD_Pos);
 
    uint8_t i = 0;
    do
    {

        if (!i2c_wait_ready(I2C_ISR_STOPF | I2C_ISR_RXNE))
            return false;
        
        if (I2C1->ISR & I2C_ISR_RXNE)
        {
            buffer[i++] = I2C1->RXDR;
        }
    }
    while (!(I2C1->ISR  & I2C_ISR_STOPF));

    I2C1->CR1 = 0;

    return true;
}
