kcuzner/led-watch/firmware/include/buzzer.h

/**
 * LED Wristwatch
 *
 * Kevin Cuzner
 */
#ifndef _BUZZER_H_
#define _BUZZER_H_

/**
 * Initializes the buzzer
 */
void buzzer_init(void);

/**
 * Triggers a beep of the buzzer
 */
void buzzer_trigger_beep(void);

#endif //_BUZZER_H_
