kcuzner/led-watch/(commit log)

2016-10-16 Added footprints for most major components
    We are missing almost all passives
    [control.sch, input.sch, leds.sch, power-supply.sch, usb.sch]
2016-10-17 Completed initial placement of major components
    The passives are causing trouble. We need to eliminate every pullup
    possible.
    [control.sch, input.sch, leds.sch, power-supply.sch, simple-led-watch.kicad_pcb, usb.sch]
2016-10-17 Finished initial placement of all components
    Got rid of several pullup resistors and unnecessary components.
    [control.sch, input.sch, leds.sch, power-supply.sch, simple-led-watch.kicad_pcb, usb.sch]
2016-10-18 Initial route of power and LED ring
    I had to do the order swapping thing that I did on the last design
    [leds.sch, simple-led-watch.kicad_pcb]
2016-10-18 Routed most of the board, except buttons and interrupts
    [control.sch, simple-led-watch.kicad_pcb]
2016-10-19 Selected programming header
    Only one non-connected trace left. And I don't know where it is...
    [control.sch, input.sch, leds.sch, simple-led-watch.kicad_pcb, usb.sch]
2016-10-20 Placed parts for round two
    I'm pretty sure I can do it better
    [control.sch, leds.sch, simple-led-watch.kicad_pcb, usb.sch]
2016-10-21 Finished round two routing
    This layout cuts through the middle of no planes and has more
    predictable power paths (without needing Hyperlynx or something like
    that). It also routes all signals but the LED-related ones on just the
    top and bottom layers, as it is meant to be. It also nearly comforms to
    the recommended layout for the regulator. There also aren't any ICs
    without a full reference plane beneath them.
    Basically, it's awesome.
    [control.sch, leds.sch, simple-led-watch.kicad_pcb]
2016-10-21 Fixed silkscreen and added markings
    [simple-led-watch.kicad_pcb]
2016-10-22 Added 3D models for most large parts
    [simple-led-watch.kicad_pcb]
2016-12-03 Added more 3D models for tall parts
    [Custom.fcstd, simple-led-watch.kicad_pcb]
2016-12-05 Changed out D65 RGB LED for a shorter 0606 part
    [Custom.fcstd, leds.sch, simple-led-watch.kicad_pcb]
2016-12-20 Adding initial case model
    [case.fcstd]
2016-12-21 Changed case to a two-piece snapping design
    Results:
    - After adding a serious chamfer on the bottom of the lid, the pieces
    "snapped" together...by acting as a lever on the tabs on the bottom
    piece and breaking them off. The clips on the tabs are too big (0.5mm).
    - Tolerances are very tight on the vertical sections. The circular
    tolerances between the lid and bottom are good. This contributed to the
    snapping of the tabs.
    [case.fcstd]
2017-01-14 Upgrade to latest kicad, add some measurements
    [control.sch, input.sch, leds.sch, power-supply.sch, simple-led-watch.kicad_pcb, simple-led-watch.sch, usb.sch]
2017-01-14 Checked layout and reference designs, swapped crystal and RGB LED
    ST has a list of suggested crystals which are known to work with the
    STM32L0 family. I selected one of those and it is significantly
    smaller in all dimensions.
    The RGB LED had too high of a green voltage. I swapped it out for a
    slightly more expensive one with the same footprint that had startlingly
    low green and blue forward voltages.
    For layout changes:
    - Fixed regulator footprint silkscreen
    - Fixed regulator layout to be closer to reference design
    - Fixed inductor silkscreen
    - Moved accelerometer downward to accomodate capacitors above
    - Fixed accelerometer layout to have no traces beneath
    - Fixed accelerometer silkscreen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
    [control.sch, input.sch, leds.sch, power-supply.sch, simple-led-watch.kicad_pcb]
2017-01-14 Made some modifications to solder mask and traces for oshpark
    [simple-led-watch.kicad_pcb]
2017-01-15 Added date and revision to schematic and layout
    [control.sch, input.sch, leds.sch, power-supply.sch, simple-led-watch.kicad_pcb, simple-led-watch.sch, usb.sch]
2017-01-29 Fixed solder paste mask over the DHVQFN24
    [simple-led-watch.kicad_pcb]
2017-01-29 Added intial firmware with LED test
    The test is simple: Light up every LED.
    Turns out, that doesn't quite work. The 74HC154 raises the voltage at
    its outputs as current is sunk into them, so the blue LEDs don't
    illuminate very strongly (the center blue LED doesn't illuminate visibly
    at all). This may be a problem, but we don't really intend to have more
    than two LEDs per segment illuminated.
    [flash.cfg]
2017-01-30 Added initial buzzer and button control firmware
    [buttons.c, buttons.h, buzzer.c, buzzer.h, main.c]
2017-01-31 Added initial LED driver
    The test program makes a fun counting ring. I definitely did not count
    on the output resistance of the 74HC154 causing the blue LED to become
    marginally turned on when 4-5 red LEDs are lit. Very interesting.
2017-02-02 Fixed LED ISR and buzzer duty cycle voltage droop
    LED ISR: I forgot to reset the status register, so it would continuously
    execute. I also found that I needed to up the refresh rate by a lot to
    remove visible flicker. I suspect this stems from the fact that all
    segments are blanked except the one currently being illuminated.
    Buzzer duty cycle: The buzzer at 50% draws ~100mA average, with ~200mA
    peak, according to the datasheet. On the voltage rail, there is an
    extremely noticable droop, though it follows a roughly triangular curve,
    likely due to the inductance of the buzzer coil (it is magnetic).
    Reducing the duty cycle to roughly 2% completely eliminates the
    resulting LED flicker at the ex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
    [buttons.c, buzzer.c, leds.c]
2017-02-02 Added initial I2C peripheral driver
    It does simple read-only or write-only transactions. This should be
    enough to operate the accelerometer.
2017-02-04 Added initial accelerometer code with pulse detection
2017-02-06 Added initial USB code without endpoint 0 handling
    The STM32L0 does the PMA just a tad differently than the STM32F1. The
    device can receive commands now.
2017-02-13 Tweaked setup state machine and packet handling. Device now enumerates.
2017-02-17 Fixed endpointa address and Linux will now poll the device
    Linux only starts polling the device once the device is opened. I wonder
    if Windows has similar behavior?
2017-02-26 Added initial battery charge & usb detection, required bodge
    The bodge was adding a 4.7K resistor between the base and emitter of Q1
    and changing R4 to be 20K. The issue is that *something* is leaking 2V
    onto the 5V line, which is enough to turn on Q1 through a 10K resistor.
    I suspect the battery charger, but I guess it could be the diode I
    specifically selected for a low leakage current. In any case, the
    20K/4.7K voltage divider prevents the transistor from turning on until
    at least ~4V is present on the line. Ideally it would have been exactly
    4.5V, but my supply of surface mount resistors is a tad limited.
    [main.c, power.c, power.h]
2017-03-04 Added initial power management state machine, with stop mode
    It behaves like its in stop mode...so hopefully its in stop mode.
2017-03-04 Added initial clock speed management with callbacks
    It does actually seem to work. When the USB is disconnected, changing
    the MSI range really has a crazy effect on the display. Reconnecting the
    USB makes the artifacts disappear. All the while, the buzzer sounds the
    same frequency. I think it works.
    [buzzer.c, i2c.c, main.c, osc.c, osc.h, power.c, usb.h]
2017-03-20 Added solder paste stencil blender file
    [stencil.blend]
2017-03-20 Initial case SCAD, with PCB
    [case.scad]
2017-03-21 Added additional cutouts to case
    A blank PCB fits perfectly. However, there is very little room for
    wiring the battery. The programming header is getting in the way and the
    wires also seem to be weakening, so I may need to replace the connector.
    This case version does not have the button slots.
    [case.scad]
2017-03-29 Added button cutouts to case with space for button caps
    [case.scad]
2017-03-30 Made a minor outside diameter change to remove a void around USB
    This is why doing this in OpenSCAD is great
    [case.scad]
2017-04-02 Expanded on bootloader description, changed bootloader to be in flash
    The bootloader is now truly a bootloader. Hooray.
    [flash.cfg]
2017-04-08 Added lid to case, shortened lid, added spring bar holes
    The battery compartment wasn't quite deep enough for the buzzer.
    [case.scad]
2017-04-08 Removed freecad version of case since we will be sticking with openscad
    [case.fcstd]
2017-04-10 Added lip to case and adjusted programming header height
    Making the lid just a touch larger moved the programming header in range
    of the connector.
    [case.scad]
2017-04-15 Added case+PCB art blender file
2017-04-15 Fixed excessive sleep current consumption originating in the blue LEDs
    Turns out, the blue LEDs don't have a reverse current specification and
    they weren't designed to operate under reverse voltage. I missed that
    little tidbit in the datasheet and now I know what they do when reverse
    voltaged: They draw collectively 28mA or so through the microcontroller,
    even when sleeping. The reason is that since the mux is disabled and the
    hour pin is most likely set low (unless it happened to turn off when
    muxing through the active hour segment), that current is drawn in
    reverse through the LEDs. The software fix is to simply set the blue pin
    high when we disable the LEDs. Current consumption in sleep m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
    [leds.c]
2017-04-15 Widened the button holes further
    [case.scad]
2017-04-18 Fixed usb implementation to allow overriding ZLP production
    Apparently the HID class does not use ZLPs. I *think* this should still
    be ok in the case of a report longer than the endpoint size and a
    multiple of the endpoint size since we already implement multi-transfer
    packetizing of buffers and that functionality still remains.
    [usb.c, usb.h]
2017-04-19 Fixed problems with NOZLP and specific packet sizes
    In the event that a packet size was a multiple of the endpoint size, the
    device would be unable to send or receive more than the first <endpoint
    size> bytes. Additional logic was added to ensure that transfers are
    only completed once the expected number of bytes were sent or received.
    This still adds some additional peril for receivers which expect packets
    longer than the endpoint size since it will no longer complete a receive
    operation if the number of bytes received is a multiple of the endpoint
    size (since there is no longer a way to tell if a transmission is
    complete in that case).
    Long story short, it won't choke on packets longer th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
    [usb.c, usb.h]
2017-04-27 Removed flash write test
    Every time we reset the chip it would do a flash write
    [bootloader.c]
2017-05-05 Created programming state machine and host hex loader
    Still working out some bugs with the CRCs
    [bootloader.c, bootloader.h, main.c]
2017-05-08 Fixed CRC32 implementation, device now appears to be programmable!
    [bootloader.c]
2017-05-08 Increased poll rate to maximum and added progress bar to polling script
    I believe that the data rate is being limited by the handshaking that
    happens by enforcing a status report to be sent after every page
    command. However, this does allow us to stop programming and determine
    which page caused the error. Perhaps I need to rethink the status
    reports so that I can remove the ordering dependency.
    [bootloader.c]
2017-05-10 Added bootloader reset/entry and program start logic
    The device can now be programmed entirely over USB, provided that the
    user program implements some way to soft-reset the device.
    [bootloader.c, bootloader.h, main.c]
2017-05-10 Modified firmware Makefile to use the bootloader for installation
    [flash.cfg]
